SerdarCS/cpsproject/README.md

Cyberphysical Systems group project submission
